niccolascassel/jardimdosol/README.md

jardimdosol
===========

Jardim do Sol allotment's projects
