niccolascassel/jardimdosol/(list of files, cad)

Other CAD files:
Drawings/ADUTORA ALIMENTACAO.dwg
Drawings/04 - Layout do Quadro Eletrico e Listas de Componentes e Bornes.dwg
Drawings/02 - Detalhamento Sensores Booster.dwg
Drawings/01 - Detalhamento Posicionamento e Fixação QGBT.dwg
Drawings/INFRA-AG-BOOSTER-JARDIM_SOL-R00.dwg
Drawings/03 - Esquema Eletrico do Painel de Acionamento da Bomba.dwg
